angunsidar/robot-kol-servo/cad/step/servo_kol_montaj.step

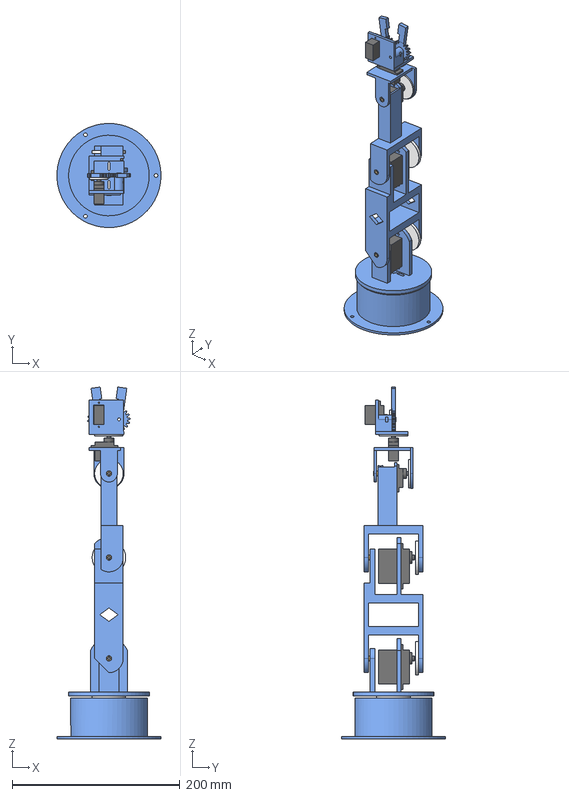
[picture p5: CAD file, 2026-10-22]
cad/step/servo_kol_montaj.step
123.9 x 123.9 x 419.1 mm
taban
servo_J1
govde
horn_J1
servo_J2
burc_J2
ust_kol
horn_J2
servo_J3
burc_J3
on_kol
horn_J3
servo_J5
burc_J5
bilek
horn_J5
servo_J4
tutucu_govde
horn_J4
servo_tutucu
burc_tutucu
cene_A
horn_tutucu
cene_B
