angunsidar/robot-kol-servo/cad/step/burc_SG.step

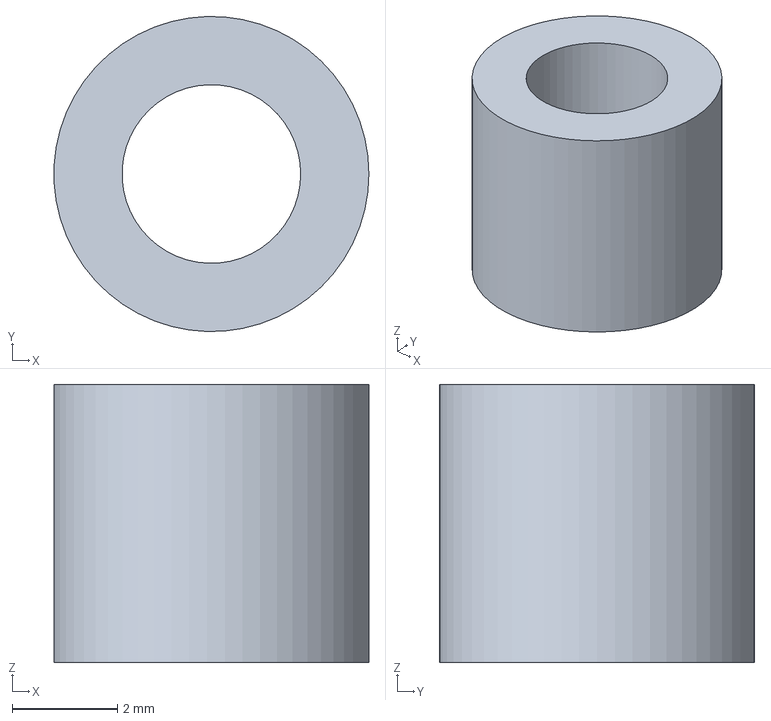
[picture p6: CAD file, 2026-10-22]
cad/step/burc_SG.step
6.00 x 6.00 x 5.30 mm
