angunsidar/robot-kol-servo/cad/step/on_kol.step

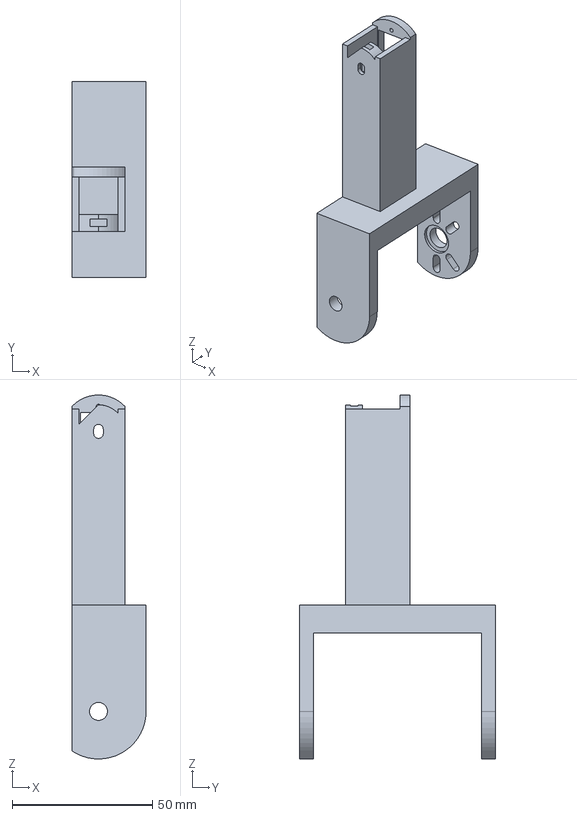
[picture p7: CAD file, 2026-10-22]
cad/step/on_kol.step
26.5 x 70.0 x 130.0 mm
