angunsidar/robot-kol-servo/cad/step/govde.step

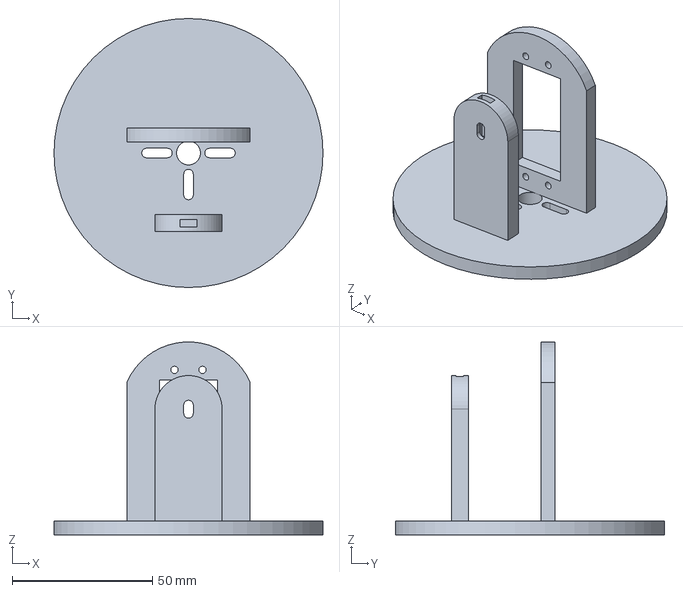
[picture p8: CAD file, 2026-10-22]
cad/step/govde.step
96.0 x 96.0 x 68.9 mm
