angunsidar/robot-kol-servo/cad/step/cene_B.step

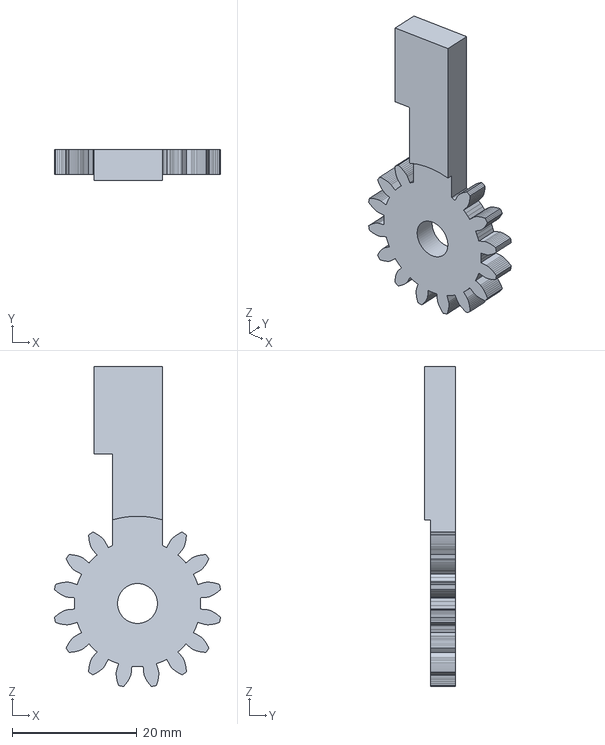
[picture p9: CAD file, 2026-10-22]
cad/step/cene_B.step
26.6 x 5.00 x 51.3 mm
