angunsidar/robot-kol-servo/cad/step/ust_kol.step

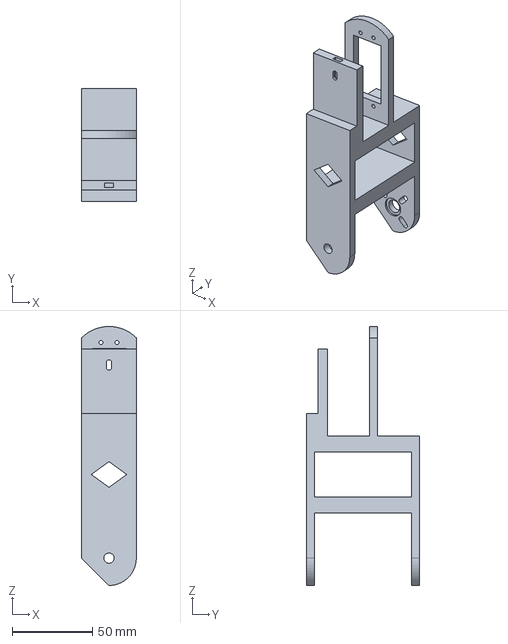
[picture p10: CAD file, 2026-10-22]
cad/step/ust_kol.step
34.0 x 70.0 x 161.0 mm
