angunsidar/robot-kol-servo/cad/step/burc_tutucu.step

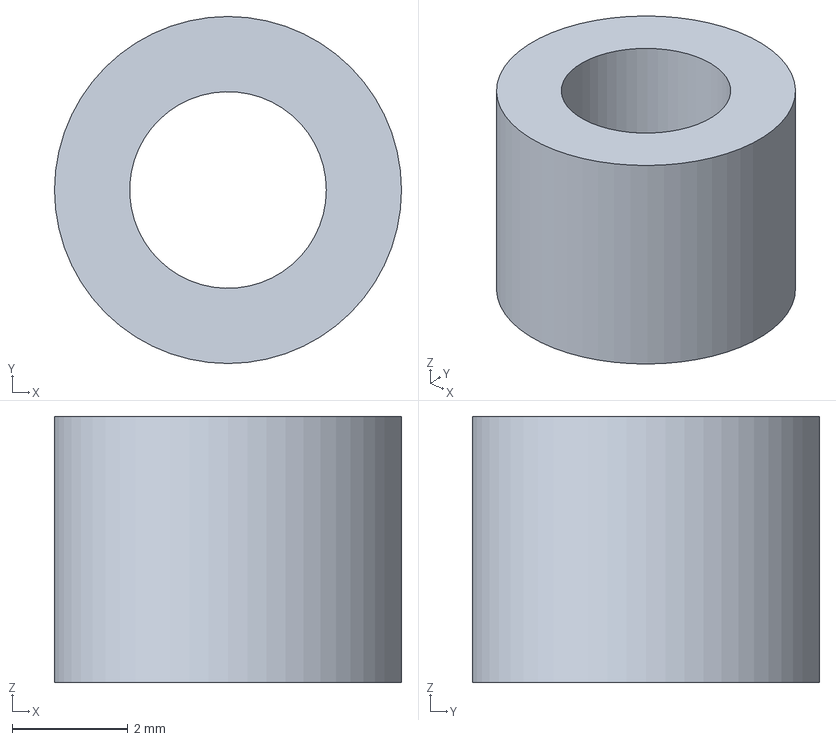
[picture p11: CAD file, 2026-10-22]
cad/step/burc_tutucu.step
6.00 x 6.00 x 4.60 mm
