angunsidar/robot-kol-servo/cad/step/tutucu_govde.step

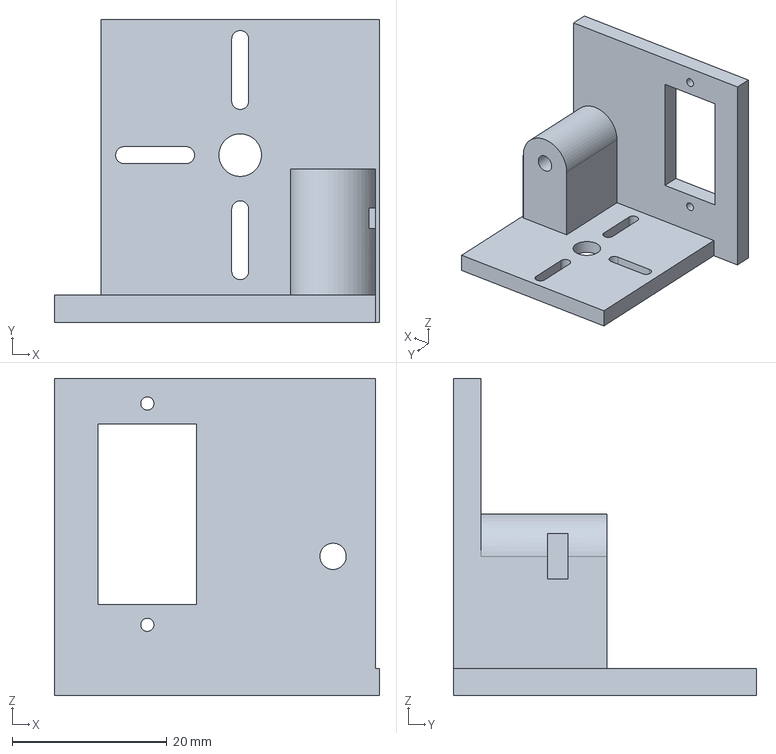
[picture p12: CAD file, 2026-10-22]
cad/step/tutucu_govde.step
42.0 x 39.1 x 41.0 mm
