angunsidar/robot-kol-servo/cad/step/cene_A.step

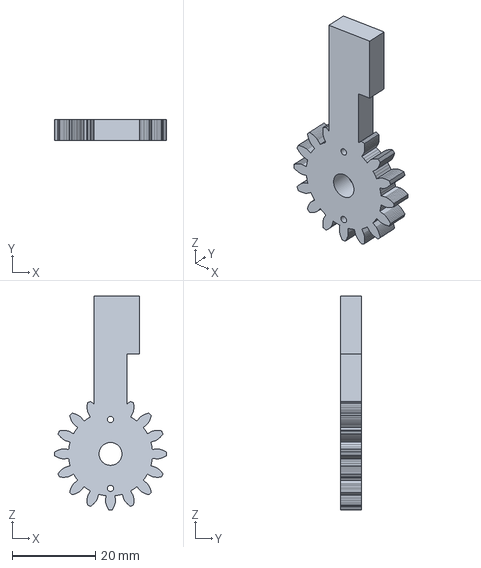
[picture p13: CAD file, 2026-10-22]
cad/step/cene_A.step
27.0 x 5.00 x 51.5 mm
