angunsidar/robot-kol-servo/cad/step/taban.step

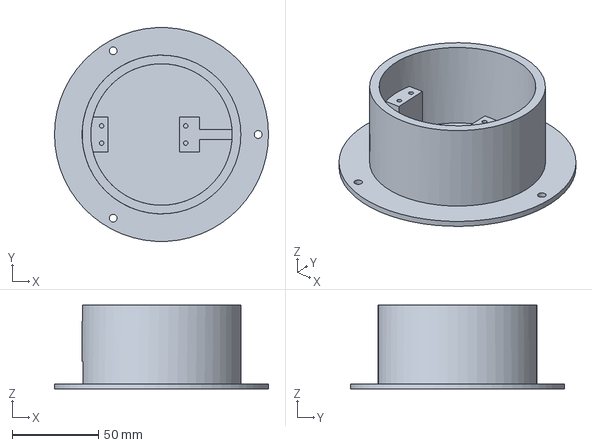
[picture p14: CAD file, 2026-10-22]
cad/step/taban.step
124.0 x 123.8 x 48.6 mm
