angunsidar/robot-kol-servo/cad/step/burc_MG.step

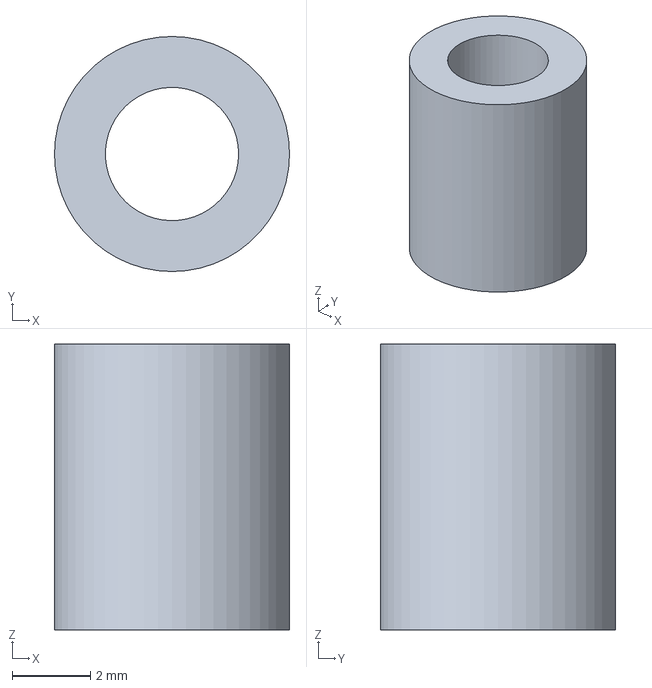
[picture p15: CAD file, 2026-10-22]
cad/step/burc_MG.step
6.00 x 6.00 x 7.30 mm
