angunsidar/robot-kol-servo/cad/step/bilek.step

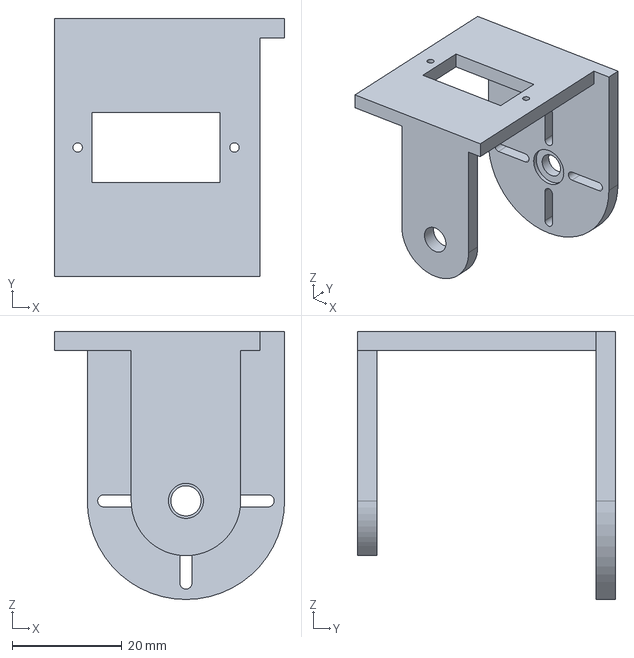
[picture p16: CAD file, 2026-10-22]
cad/step/bilek.step
42.0 x 47.0 x 48.9 mm
