angunsidar/robot-kol-servo/(list of files, cad)

Other CAD files:
cad/stl/bilek.stl
cad/stl/burc_MG.stl
cad/stl/burc_SG.stl
cad/stl/burc_tutucu.stl
cad/stl/cene_A.stl
cad/stl/cene_B.stl
cad/stl/govde.stl
cad/stl/on_kol.stl
cad/stl/taban.stl
cad/stl/tutucu_govde.stl
cad/stl/ust_kol.stl
