angunsidar/robot-kol-servo/ros2/servo_kol_description/urdf/servo_kol.urdf

<?xml version="1.0"?>
<!-- urdf_uret.py ile üretildi; elle düzenleme. Ölçü ve kütleler TAHMİN. -->
<robot name="servo_kol">
  <material name="mavi"><color rgba="0.12 0.37 0.75 1"/></material>
  <material name="gri"><color rgba="0.73 0.76 0.78 1"/></material>
  <material name="beyaz"><color rgba="0.94 0.94 0.94 1"/></material>
  <material name="turuncu"><color rgba="0.85 0.4 0.1 1"/></material>

  <link name="taban">
    <visual>
      <origin xyz="0 0 0.03" rpy="0 0 0"/>
      <geometry><cylinder radius="0.055" length="0.06"/></geometry>
      <material name="gri"/>
    </visual>
    <collision>
      <origin xyz="0 0 0.03" rpy="0 0 0"/>
      <geometry><box size="0.11 0.11 0.06"/></geometry>
    </collision>
    <inertial>
      <origin xyz="0 0 0.03" rpy="0 0 0"/>
      <mass value="0.2"/>
      <inertia ixx="0.000261667" ixy="0" ixz="0" iyy="0.000261667" iyz="0" izz="0.000403333"/>
    </inertial>
  </link>

  <joint name="j1_govde" type="revolute">
    <parent link="taban"/>
    <child link="govde"/>
    <origin xyz="0 0 0" rpy="0 0 0"/>
    <axis xyz="0 0 1"/>
    <limit lower="-1.5708" upper="1.5708" effort="0.921825" velocity="1.16355"/>
  </joint>

  <link name="govde">
    <visual>
      <origin xyz="0 0 0.078" rpy="0 0 0"/>
      <geometry><box size="0.04 0.056 0.036"/></geometry>
      <material name="mavi"/>
    </visual>
    <collision>
      <origin xyz="0 0 0.078" rpy="0 0 0"/>
      <geometry><box size="0.04 0.056 0.036"/></geometry>
    </collision>
    <inertial>
      <origin xyz="0 0 0.078" rpy="0 0 0"/>
      <mass value="0.105"/>
      <inertia ixx="3.878e-05" ixy="0" ixz="0" iyy="2.534e-05" iyz="0" izz="4.144e-05"/>
    </inertial>
  </link>

  <joint name="j2_omuz" type="revolute">
    <parent link="govde"/>
    <child link="ust_kol"/>
    <origin xyz="0 0 0.096" rpy="0 0 0"/>
    <axis xyz="0 1 0"/>
    <limit lower="-1.309" upper="1.309" effort="0.921825" velocity="1.16355"/>
  </joint>

  <link name="ust_kol">
    <visual>
      <origin xyz="0 0 0.06" rpy="0 0 0"/>
      <geometry><box size="0.026 0.018 0.12"/></geometry>
      <material name="mavi"/>
    </visual>
    <collision>
      <origin xyz="0 0 0.06" rpy="0 0 0"/>
      <geometry><box size="0.026 0.018 0.12"/></geometry>
    </collision>
    <inertial>
      <origin xyz="0 0 0.06" rpy="0 0 0"/>
      <mass value="0.121"/>
      <inertia ixx="0.000148467" ixy="0" ixz="0" iyy="0.000152016" iyz="0" izz="1.00833e-05"/>
    </inertial>
  </link>

  <joint name="j3_dirsek" type="revolute">
    <parent link="ust_kol"/>
    <child link="on_kol"/>
    <origin xyz="0 0 0.12" rpy="0 0 0"/>
    <axis xyz="0 1 0"/>
    <limit lower="-1.39626" upper="1.39626" effort="0.921825" velocity="1.16355"/>
  </joint>

  <link name="on_kol">
    <visual>
      <origin xyz="0 0 0.05" rpy="0 0 0"/>
      <geometry><box size="0.024 0.016 0.1"/></geometry>
      <material name="mavi"/>
    </visual>
    <collision>
      <origin xyz="0 0 0.05" rpy="0 0 0"/>
      <geometry><box size="0.024 0.016 0.1"/></geometry>
    </collision>
    <inertial>
      <origin xyz="0 0 0.05" rpy="0 0 0"/>
      <mass value="0.051"/>
      <inertia ixx="4.3588e-05" ixy="0" ixz="0" iyy="4.4948e-05" iyz="0" izz="3.536e-06"/>
    </inertial>
  </link>

  <joint name="j5_bilek_egim" type="revolute">
    <parent link="on_kol"/>
    <child link="bilek"/>
    <origin xyz="0 0 0.1" rpy="0 0 0"/>
    <axis xyz="0 1 0"/>
    <limit lower="-1.5708" upper="1.5708" effort="0.11768" velocity="1.16355"/>
  </joint>

  <link name="bilek">
    <visual>
      <origin xyz="0 0 0.006" rpy="0 0 0"/>
      <geometry><box size="0.022 0.022 0.012"/></geometry>
      <material name="mavi"/>
    </visual>
    <collision>
      <origin xyz="0 0 0.006" rpy="0 0 0"/>
      <geometry><box size="0.022 0.022 0.012"/></geometry>
    </collision>
    <inertial>
      <origin xyz="0 0 0.006" rpy="0 0 0"/>
      <mass value="0.01"/>
      <inertia ixx="5.23333e-07" ixy="0" ixz="0" iyy="5.23333e-07" iyz="0" izz="8.06667e-07"/>
    </inertial>
  </link>

  <joint name="j4_bilek_donus" type="revolute">
    <parent link="bilek"/>
    <child link="tutucu_govde"/>
    <origin xyz="0 0 0" rpy="0 0 0"/>
    <axis xyz="0 0 1"/>
    <limit lower="-1.5708" upper="1.5708" effort="0.11768" velocity="1.16355"/>
  </joint>

  <link name="tutucu_govde">
    <visual>
      <origin xyz="0 0 0.024" rpy="0 0 0"/>
      <geometry><box size="0.046 0.014 0.024"/></geometry>
      <material name="beyaz"/>
    </visual>
    <collision>
      <origin xyz="0 0 0.024" rpy="0 0 0"/>
      <geometry><box size="0.046 0.014 0.024"/></geometry>
    </collision>
    <inertial>
      <origin xyz="0 0 0.024" rpy="0 0 0"/>
      <mass value="0.018"/>
      <inertia ixx="1.158e-06" ixy="0" ixz="0" iyy="4.038e-06" iyz="0" izz="3.468e-06"/>
    </inertial>
  </link>

  <link name="parmak_sag">
    <visual>
      <origin xyz="0 0 0.01525" rpy="0 0 0"/>
      <geometry><box size="0.006 0.012 0.0305"/></geometry>
      <material name="beyaz"/>
    </visual>
    <collision>
      <origin xyz="0 0 0.01525" rpy="0 0 0"/>
      <geometry><box size="0.006 0.012 0.0305"/></geometry>
    </collision>
    <inertial>
      <origin xyz="0 0 0.01525" rpy="0 0 0"/>
      <mass value="0.007"/>
      <inertia ixx="6.26646e-07" ixy="0" ixz="0" iyy="5.63646e-07" iyz="0" izz="1.05e-07"/>
    </inertial>
  </link>

  <joint name="tutucu" type="prismatic">
    <parent link="tutucu_govde"/>
    <child link="parmak_sag"/>
    <origin xyz="0 0 0.0645" rpy="0 0 0"/>
    <axis xyz="1 0 0"/>
    <limit lower="0.0005" upper="0.035" effort="0.11768" velocity="0.05"/>
  </joint>

  <link name="parmak_sol">
    <visual>
      <origin xyz="0 0 0.01525" rpy="0 0 0"/>
      <geometry><box size="0.006 0.012 0.0305"/></geometry>
      <material name="beyaz"/>
    </visual>
    <collision>
      <origin xyz="0 0 0.01525" rpy="0 0 0"/>
      <geometry><box size="0.006 0.012 0.0305"/></geometry>
    </collision>
    <inertial>
      <origin xyz="0 0 0.01525" rpy="0 0 0"/>
      <mass value="0.007"/>
      <inertia ixx="6.26646e-07" ixy="0" ixz="0" iyy="5.63646e-07" iyz="0" izz="1.05e-07"/>
    </inertial>
  </link>

  <joint name="tutucu_ayna" type="prismatic">
    <parent link="tutucu_govde"/>
    <child link="parmak_sol"/>
    <origin xyz="0 0 0.0645" rpy="0 0 0"/>
    <axis xyz="1 0 0"/>
    <limit lower="-0.035" upper="-0.0005" effort="0.11768" velocity="0.05"/>
    <mimic joint="tutucu" multiplier="-1" offset="0"/>
  </joint>

  <link name="uc"/>
  <joint name="uc_sabit" type="fixed">
    <parent link="tutucu_govde"/>
    <child link="uc"/>
    <origin xyz="0 0 0.095" rpy="0 0 0"/>
  </joint>

</robot>
