angunsidar/robot-kol-servo/(commit log)

2026-10-21 Servo robot kol: firmware, simülasyon, kamera, araçlar ve testler
    How To Mechatronics mekaniği üzerine 5 eksen + tutucu servo kol (3x MG996R,
    3x SG90, Arduino Uno, HC-05):
    - Arduino: uygulamayla uyumlu ayrıştırıcı, senkron ve ivme sınırlı hareket,
    0,1° çözünürlük, EEPROM'da 50 poz, NeoSWSerial ile Bluetooth
    - Sayfa: firmware ile bit bit aynı dijital ikiz, ters kinematik, program,
    montaj kalibrasyonu, Web Serial ile gerçek kola bağlanma
    - Kamera: homografi, kolla otomatik kalibrasyon, eğik bakışta taban bulma,
    küp yönü, renge göre ayırma ve kavrama doğrulaması
    - Python istemcisi, URDF ve ROS 2 iskeleti
    - Testler: python testleri_calistir.py, GitHub Actions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
    [servo_kol.urdf]
2026-10-21 Parça listesi: 22 Ekim fiyatları, prize takılan adaptör
    - Fiyat ve stoklar ürün sayfalarından yeniden okundu; siparişin çoğu tek
    mağazada (Robocombo), adaptör Direnç.net'ten. Toplam ~2,7–4,2 bin TL.
    - MG996R'nin önceki ucuz satıcılarında stok yok; Robocombo'da 200,50 TL.
    - Adaptör önerisi düzeltildi: metal kasalı panel tipi kaynak yerine prize
    takılan 5 V 5 A adaptör (220 V'u açık klemense bağlamak gerekmiyor).
    - HC-05 bölücüsünde 2 kΩ = iki 1 kΩ seri; tutucu için M3×20 yeterli.
2026-10-22 Kendi basılabilir parçalar: CadQuery tasarımı, çakışma taraması, sim ölçüleri
    - cad/: MG996R/SG90 ölçülerine göre parametrik parçalar (taban, gövde, üst kol,
    ön kol, bilek, tutucu, evolvent dişli çeneler, burçlar); tek ölçü kaynağı
    geometri.py, 142 eklem konumunda katı çakışma taraması (0 çakışma),
    kontrol.py ile 47 tasarım kontrolü, STEP/STL çıktısı
    - Simülasyon sayfası artık basılacak parçaların kendisini gösteriyor
    (sim/servo_mesh.js), tutucu ağzı tasarım tablosundan
    - Kinematik ölçüler tasarıma geçti: H0 96, L4 95 mm; parça kütleleri hacimden;
    URDF yeniden üretildi; tutucu varsayılan açık açısı 70°
    - onshape/onsh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
    [bilek.step, bilek.stl, burc_MG.step, burc_MG.stl, burc_SG.step, burc_SG.stl, burc_tutucu.step, burc_tutucu.stl]
2026-10-22 Tasarımı cilala: desteksiz baskı, tornavida erişimi, dayanım ve devrilme kontrolleri
    - cad/baski.py: 0,5 mm voksel ile 6 yönde destek analizi (köprü / çıkıntı /
    havada başlayan bölge) ve ışınla en ince duvar; 11/11 parça desteksiz,
    duvarlar >= 1,2 mm
    - Üst kol ve ön kol yan yatık basılacak biçimde: düz taban, 45° pahlı uçlar,
    sivri uçlu hafifletme pencereleri (üst kol 84 -> 66 cm³)
    - Horn olukları merkez delikten uzaklaştırıldı (0,4-0,9 mm ince et giderildi),
    göbek havşası eklendi; çatal-yanak boşluğu 2 mm (horn yüksekliği belirsizliği)
    - J5 yanağı 6 mm, tutucu dişli göbeği tabana sütunla bağlandı
    - model.py: montaj sırasına göre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
    [bilek.step, bilek.stl, burc_MG.step, burc_MG.stl, burc_SG.step, burc_SG.stl, burc_tutucu.step, burc_tutucu.stl]
2026-10-22 Statik mukavemet hesabı; çatal köprüleri 10 mm; Onshape v2
    - cad/mukavemet.py + MUKAVEMET.md: CAD kütleleriyle eklem tepkileri (50 g x 1,5
    dinamik, 200 g aşırı yük, servo durma torku), 19 kesit + 7 bağlantı, PLA katman
    içi / katmanlar arası ayrımı (Prusament veri sayfası), emniyet 3, uç sehimi
    - Bulgu: eklem momenti çatal köprüsünden burulmayla geçiyor ve yan yatık baskıda
    kayma katmanlar arasına düşüyor; ön kol köprüsünde durma torkunda emniyet ~1,3
    idi. Köprüler 5 -> 10 mm (en kritik kesit artık izin değerinin %69'u)
    - Taşıma: 200 g tam uzanıkta kaldırılamaz (omuz durma torkunun %97'si)
    - Onshape v2 belgesi: hacimler CadQuery ile birebir, Ch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
    [bilek.step, burc_MG.step, burc_SG.step, burc_tutucu.step, cene_A.step, cene_B.step, govde.step, on_kol.step]
